takoyaki9n/watering/Watering.kicad_sch

## KiCad design Watering.kicad_sch (2023-07-26)

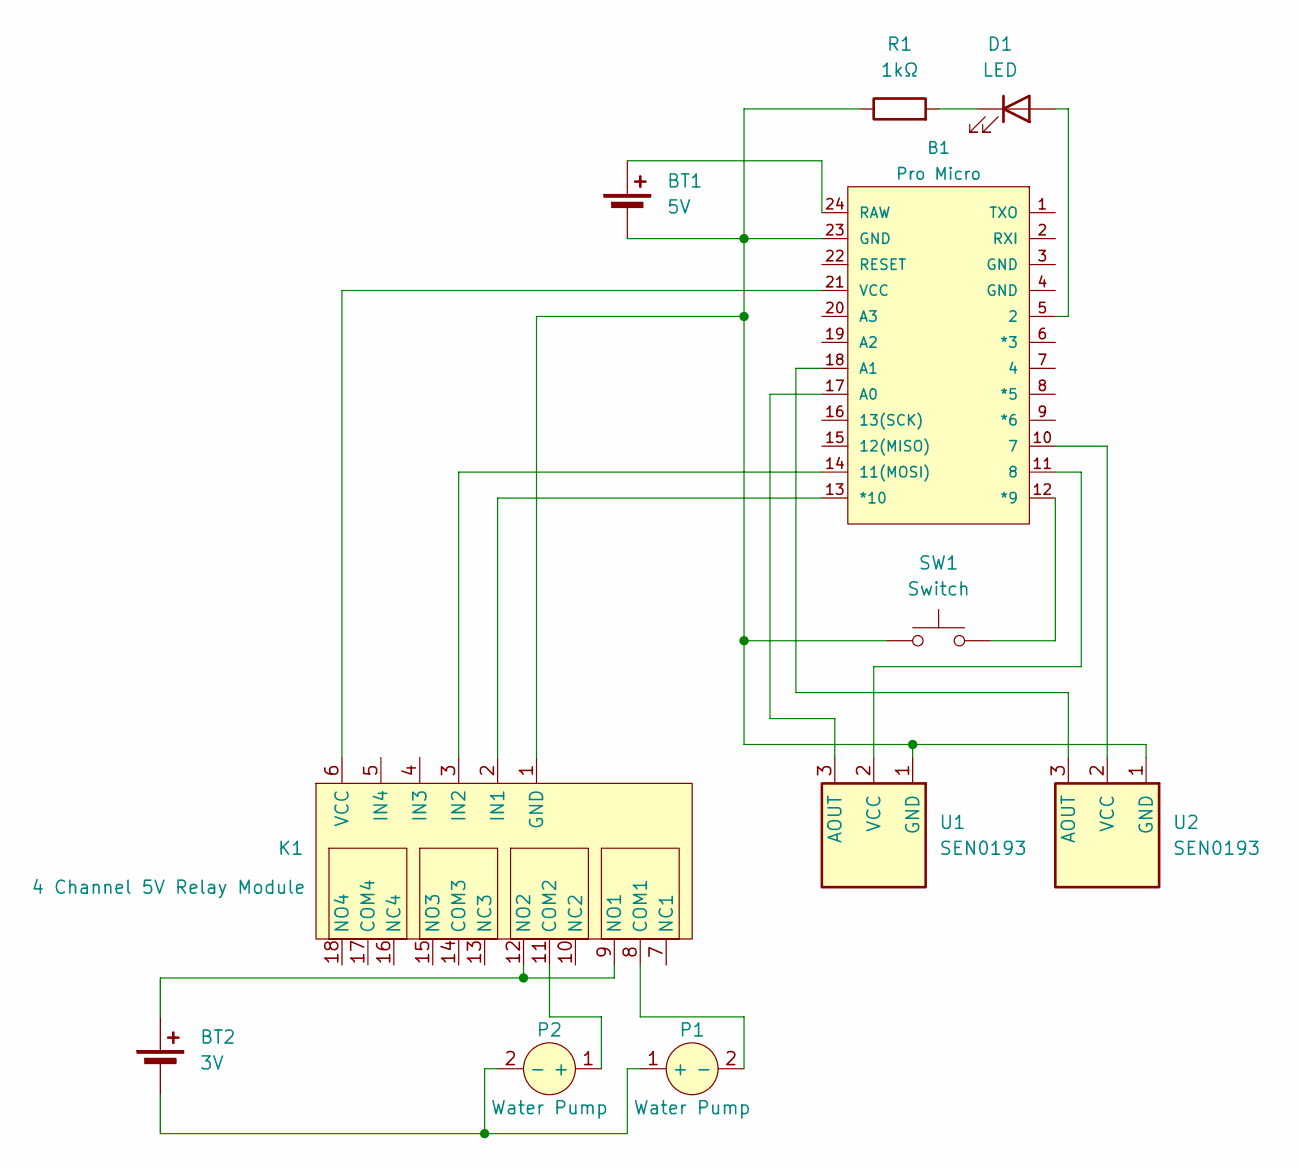
[picture p2: schematic Watering.kicad_sch]

Parts:
B1: Pro Micro; SPARKFUN_PRO_MICRO
BT1: 5V
BT2: 3V
D1: LED
K1: 4 Channel 5V Relay Module
P1, P2: Water Pump
R1: 1kΩ
SW1: Switch
U1, U2: SEN0193

Connections:
unnamed: B1.5 (2), D1.2 (A)
unnamed: B1.10 (7), U2.2 (VCC)
unnamed: B1.11 (8), U1.2 (VCC)
unnamed: B1.12 (*9), SW1.2
unnamed: B1.13 (*10), K1.2 (IN1)
unnamed: B1.14 (11(MOSI)), K1.3 (IN2)
unnamed: B1.17 (A0), U1.3 (AOUT)
unnamed: B1.18 (A1), U2.3 (AOUT)
unnamed: B1.21 (VCC), K1.6 (VCC)
unnamed: B1.23 (GND), BT1.2 (-), K1.1 (GND), R1.1, SW1.1, U1.1 (GND), U2.1 (GND)
unnamed: B1.24 (RAW), BT1.1 (+)
unnamed: BT2.1 (+), K1.9 (NO1), K1.12 (NO2)
unnamed: BT2.2 (-), P1.1 (+), P2.2 (-)
unnamed: D1.1 (K), R1.2
unnamed: K1.8 (COM1), P1.2 (-)
unnamed: K1.11 (COM2), P2.1 (+)
