takoyaki9n/watering/Watering.ino

#include "avr/sleep.h"
#include "avr/wdt.h"

// Time definitions for Watch-dog-timer
#define WDT_1S B00000110  // 1s
#define WDT_2S B00000111  // 2s
#define WDT_4S B00100000  // 4s
#define WDT_8S B00100001  // 8s

#define SERIAL_ON
#define SENSOR_ON

// 2 hours (= 2 * 60 * 60 / 8)
#define INTERVAL_2H 900
// 12 hours (= 12 * 60 * 60 / 8)
#define INTERVAL_12H 5400
#define INTERVAL INTERVAL_2H

const uint8_t pinButton = 9;
const uint8_t pinLED = 2;

const uint8_t pinPumps[2] = { 10, 16 };

#ifdef SENSOR_ON
const uint8_t pinPowers[2] = { 8, 7 };
const uint8_t pinSensors[2] = { A0, A1 };
const int thresholds[2] = { 500, 500 };
#endif

// Intrpt svc rtn for WDT ISR (vect)
ISR(WDT_vect) {}

void setupModules(int id) {
  pinMode(pinPumps[id], OUTPUT);
  digitalWrite(pinPumps[id], HIGH);

#ifdef SENSOR_ON
  pinMode(pinPowers[id], OUTPUT);
  digitalWrite(pinPowers[id], LOW);

  pinMode(pinSensors[id], INPUT);
#endif
}

void setupWDT(byte sleepT) {
  sleepT += B00010000;  // sleepTime + Enalbe WD-change bit-on
  MCUSR &= B11110111;   // Prepare WDT-reset-flag in MCU-status-Reg
  WDTCSR |= B00011000;  // Enable WD-system-reset + WD-change
  WDTCSR = sleepT;      // Set sleepTime + Enable WD-change
  WDTCSR |= B01000000;  // Finally, enable WDT-interrrupt
}

void setup() {
#ifdef SERIAL_ON
  Serial.begin(9600);
#endif

  pinMode(pinButton, INPUT_PULLUP);

  pinMode(pinLED, OUTPUT);
  digitalWrite(pinLED, LOW);

  setupModules(0);
  setupModules(1);

  set_sleep_mode(SLEEP_MODE_PWR_DOWN);
  setupWDT(WDT_8S);
}

void runPump(uint8_t id, unsigned long duration) {
  // `LOW` to run the pump, `HIGH` to stop it.
  digitalWrite(pinPumps[id], LOW);
  delay(duration);
  digitalWrite(pinPumps[id], HIGH);
}

#ifdef SENSOR_ON
void operateModules(uint8_t id, unsigned long duration) {
  digitalWrite(pinPowers[id], HIGH);
  delay(1000);
  // The `value` is high when it's dry.
  int value = analogRead(pinSensors[id]);
  digitalWrite(pinPowers[id], LOW);

#ifdef SERIAL_ON
  Serial.print("MOISTURE LEVEL #");
  Serial.print(id);
  Serial.print(": ");
  Serial.println(value);
#endif

  if (value > thresholds[id]) {
    runPump(id, duration);
  }
}
#endif

void deepSleep(void) {
  ADCSRA &= B01111111;  // disable ADC to save power
  sleep_enable();
  sleep_cpu();  // sleep until WDT-interrupt
  sleep_disable();
  ADCSRA |= B10000000;  // enable ADC again
}

void loop() {
#ifdef SENSOR_ON
  operateModules(0, 2000);
  operateModules(1, 2000);
#else
  runPump(0, 2000);
  runPump(1, 2000);
#endif

  for (int i = 0; i < INTERVAL; i++) {
    digitalWrite(pinLED, HIGH);
    delay(50);
    digitalWrite(pinLED, LOW);
    int button = digitalRead(pinButton);
    if (!button) break;
    deepSleep();
  }
}
