takoyaki9n/watering/(commit log)

2023-07-14 Add period of 10s to run pumps
2023-07-16 Remove LED
2023-07-16 Interrupt button & on-demand power supply
2023-07-16 Power supply pin for each sensor
2023-07-17 Add LED
2023-07-21 Disable moisture sensor
2023-07-26 Add schematic
    [Watering.kicad_sch]
